Ashen716/ECE-445-Lab-Notebook---Submit/lab_notebooks/praman/block-diagram-week1.png

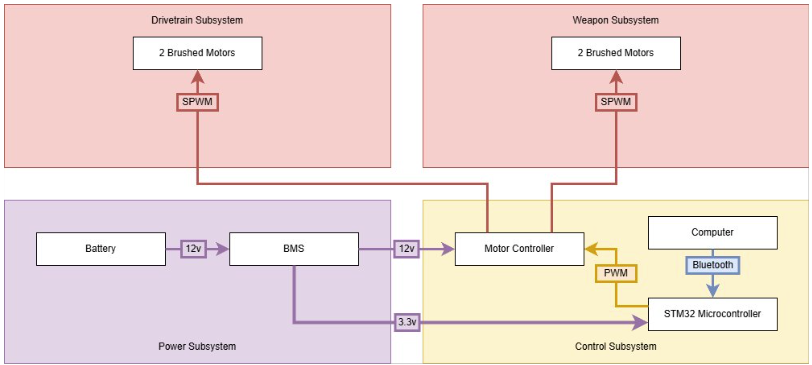
lab_notebooks/praman/block-diagram-week1.png
