Ashen716/ECE-445-Lab-Notebook---Submit/lab_notebooks/praman/h-bridge-schematic.png

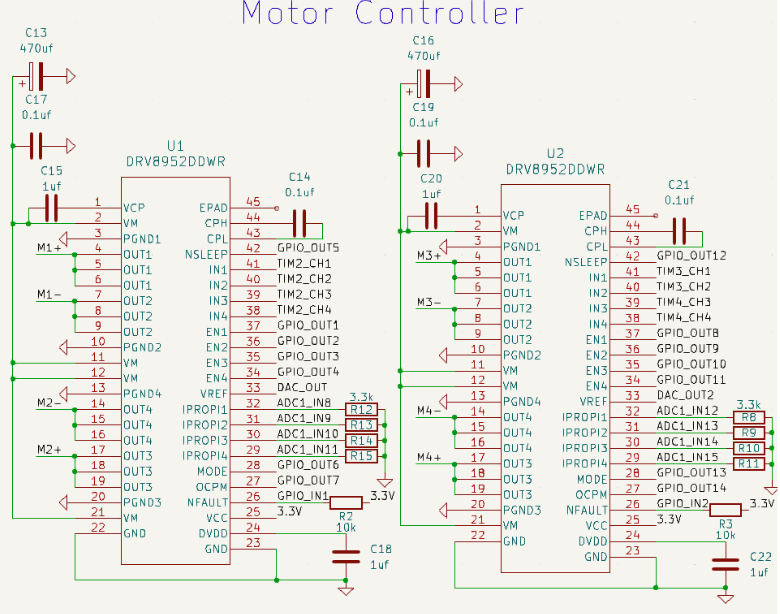
lab_notebooks/praman/h-bridge-schematic.png
