Ashen716/ECE-445-Lab-Notebook---Submit/lab_notebooks/praman/power-subsystem-schematic.png

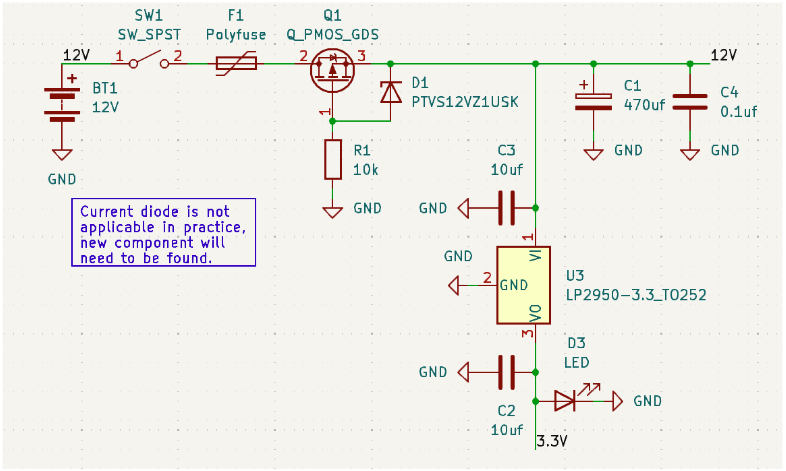
lab_notebooks/praman/power-subsystem-schematic.png
